Jekabs-Stikans/Servo_arm/Jēkaba Stikāna 2. kursa darba prezentācija.pptx

## Kursa darbs mehāniskas rokas vadības sistēma

Ventspils Augstskolas
Informācijas tehnoloģiju fakultātes
Profesionālā bakalaura studiju programmas „Elektronikas inženierija”
2. Kursa
Jēkaba Stikāna

## Saturs

- Darba mērķis un darba uzdevums
- Darba izstrādes process
1. Elektriskās principiālās shēmas izstrāde
2. Iespiedplates izstrāde
3. Shēmas lodēšana un montāža
- Secinājumi
- Izmantotie literatūras avoti

## Darba mērķis

- Izstrādāt mehāniskas rokas vadības sistēmu, kura spēj vadīt soļu motorus un satur attāluma sensoru apakšsistēmu.
- Izstrādāt projektu, kurš apvieno vairākus kursa darbus vienā.

## Darba uzdevums

- Izstrādāt mehāniskas rokas vadības sistēmu, kura var vadīt trīs soļu motorus un vienu servo motoru un satur sadursmes sensoru apakšsistēmu

## Elektroniski principiālā shēma

## Iespiedplates izstrāde

## Montāžas process

## Secinājumi

- Darba izstrādē tika sasniegti uzstādītie mērķi un nostiprinātas slektronisko shēmu projektēšanas prasmes
- Izstrādāto shēmu var turpmāk izmantot kā indikācijas sistēmu dažādās elektroniskās shēmās
- Darbu var optimizēt, izmantojot reģistru iebūvēto ieejas un izejas vadību
- Shēmu ir relatīvi viegli paplašināt uz vairāk nekā 4 ciparu izmantošanu

## Literatūras avoti

- MM74C912 mikroshēmas datu lapa
https:// (https://media.digikey.com/pdf/Data%20Sheets/Fairchild%20PDFs/MM74C912.pdf)media.digikey.com/pdf/Data%20Sheets/Fairchild%20PDFs/MM74C912.pdf
- [2] NE555 integrālās shēmas datu lapa
www.ti.com/product/NE555

## Paldies par uzmanību!
