Jekabs-Stikans/Servo_arm/Roboarm-5.png

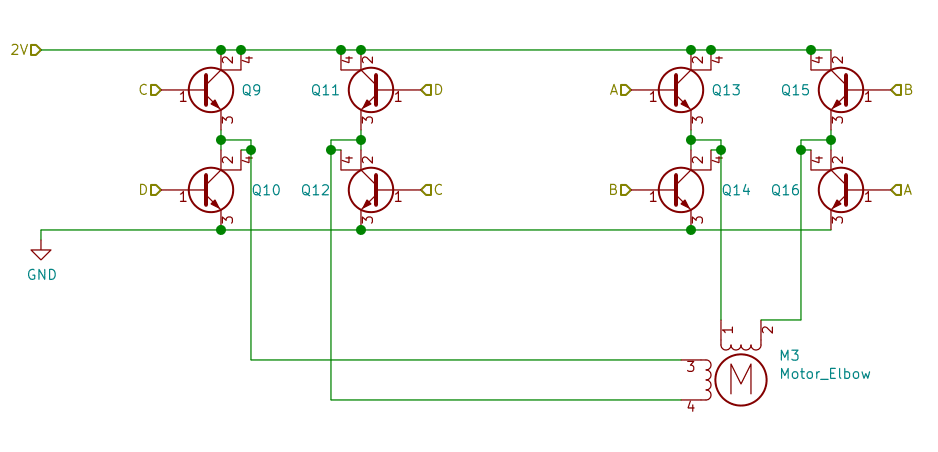
Roboarm-5.png
