Jekabs-Stikans/Servo_arm/Roboarm-6.png

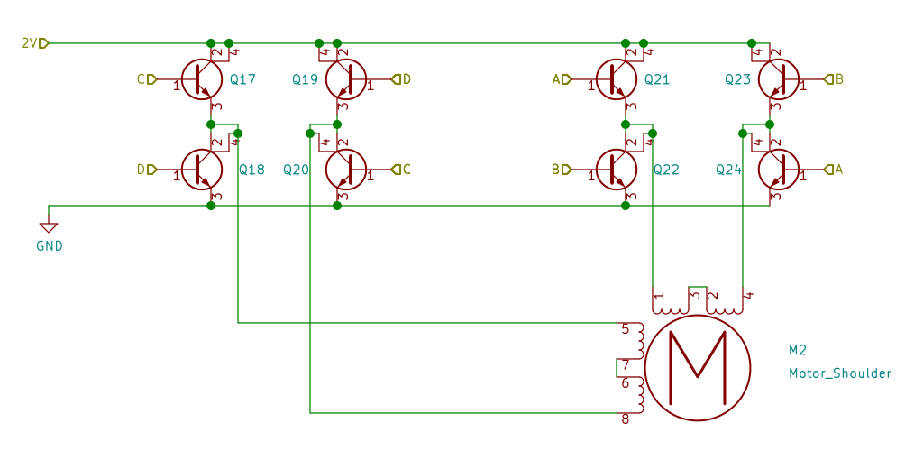
Roboarm-6.png
