Jekabs-Stikans/Servo_arm/Part list.ods

 | Jēkabs Stikāns
Nr | Nosaukums | Tiešsaiste
1 | FZT651 - Bipolar Transistor, NPN, 60 V, 2 W, 3 A, 200 hFE | https://lv.farnell.com/diodes-inc/fzt651/transistor-npn-60v-3a-sot-223/dp/9525009
2 | ST4118M1804-A - Stepper Motor, DC, 0.28 N-m, 1.8 A, Two Phase | https://lv.farnell.com/nanotec/st4118m1804-a/stepper-motor-2vdc-1-8a/dp/2507563
3 | ST5918M3008-A - Stepper Motor, DC, 0.88 N-m, 3 A, Two Phase | https://lv.farnell.com/nanotec/st5918m3008-a/stepper-motor-2-1vdc-3a/dp/2507567
4 | CRCW0805510RFKEA - SMD Chip Resistor, 0805 [2012 Metric], 510 ohm | https://lv.farnell.com/vishay/crcw0805510rfkea/res-510r-1-0-125w-0805-thick-film/dp/1653016
5 | PR02000201000JA100 - Through Hole Resistor, 100 ohm, 2 W, ± 5% | https://lv.farnell.com/vishay/pr02000201000ja100/res-100r-5-2w-axial-metal-film/dp/2614520
6 | LM358ADGKR - Operational Amplifier, 2 amplifiers 3V to 32V,MSOP, 8 Pins | https://lv.farnell.com/texas-instruments/lm358adgkr/op-amp-high-gain-700khz-msop-8/dp/3117063
7 | BC817 - Bipolar Single Transistor, NPN, 45 V, 250 mW, 500 mA, 250 hFE | https://lv.farnell.com/nexperia/bc817-40-215/transistor-npn-45v-0-5a-sot23/dp/1081225RL
8 | C0805X104K5RAC3316 - SMD Ceramic Capacitor, FT-CAP, 0.1 µF, 50 V, 0805 [2012 Metric], ± 10% | https://lv.farnell.com/kemet/c0805x104k5rac3316/cap-0-1-f-50v-10-x7r-0805/dp/2666896
9 | EEEFK1C220UR - SMD Electrolytic Capacitor, Radial Can, 22 µF, 16 V | https://lv.farnell.com/panasonic/eeefk1c220ur/cap-22-f-16v-radial-smd/dp/9695656
10 | EEEFC1H1R0R - SMD Electrolytic Capacitor, Radial Can, 1 µF, 50 V | https://lv.farnell.com/panasonic/eeefc1h1r0r/cap-1-f-50v-radial-smd/dp/9694528
11 | EEEFP1E100AR - SMD Electrolytic Capacitor, Radial Can, 10 µF, 25 V | https://lv.farnell.com/panasonic/eeefp1e100ar/cap-10-f-25v-radial-smd/dp/1539481
12 | SRN1060-331M - Power Inductor (SMD), 330 µH, 900 mA, Semishielded, 10mm x 9.8mm x 6mm | https://lv.farnell.com/bourns/srn1060-331m/inductor-330uh-20-0-9a-smd/dp/2329195
13 | TS53YJ104MR10 - Trimmer Potentiometer, 100 kohm, SMD, 250 mW, ± 20% | https://lv.farnell.com/vishay/ts53yj104mr10/trimmer-pot-100k-1turn-smd/dp/1141488
14 | TS53YL103MR10 - Trimmer Potentiometer, 10 kohm, 1 Turns, SMD, 250 mW, ± 20% | https://lv.farnell.com/vishay/ts53yl103mr10/trimmer-pot-10k-1turn-smd/dp/1141474
15 | S1ML R3 - Standard Recovery Diode, 1 kV, 1 A, Single, 1.1 V, 1.8 µs, 30 A | https://lv.farnell.com/taiwan-semiconductor/s1ml-r3/diode-sgp-1a-1000v/dp/1559155
