Jekabs-Stikans/Servo_arm/Roboarm.pdf

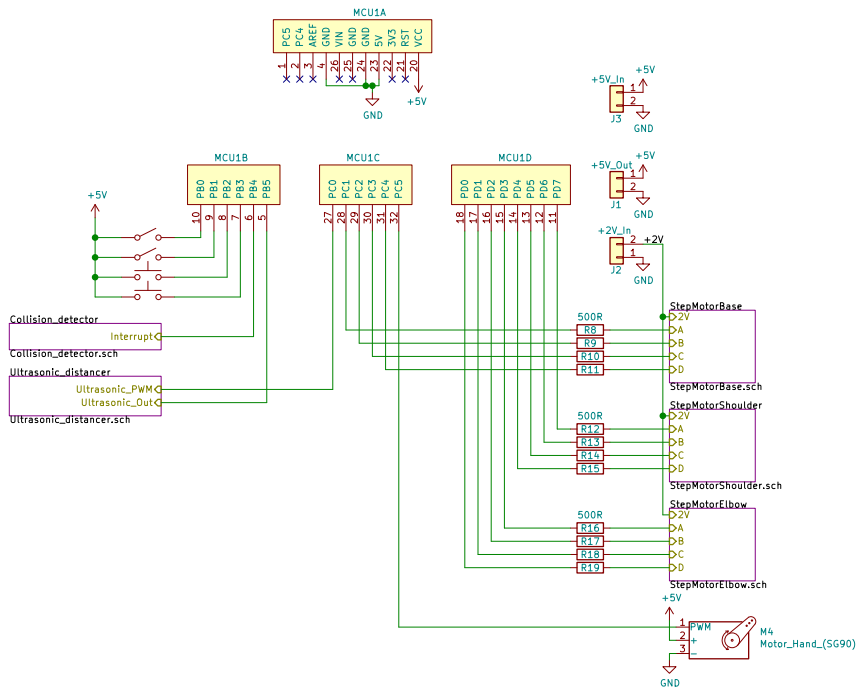
[picture p29: page 1]

2 VCC 20 RST 21 3V3 22 5V 23 GND 24 GND 25 VIN 26 AREF

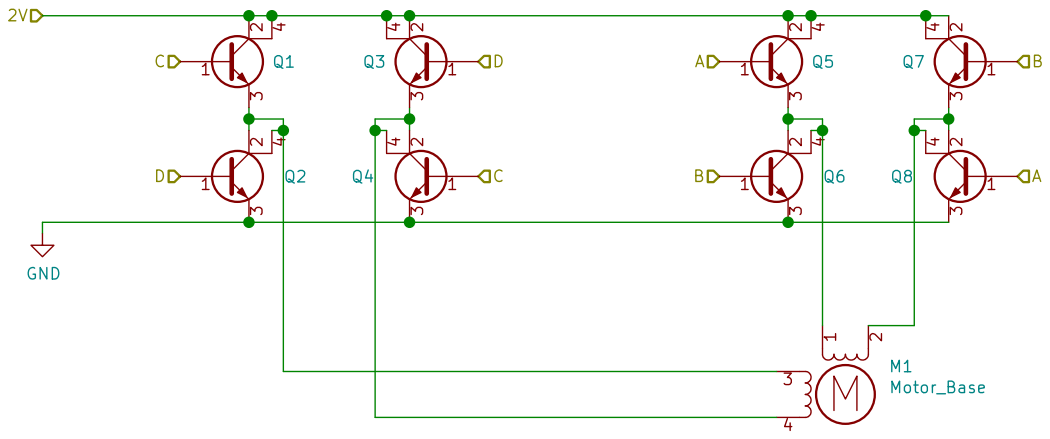
[picture p30: page 2]

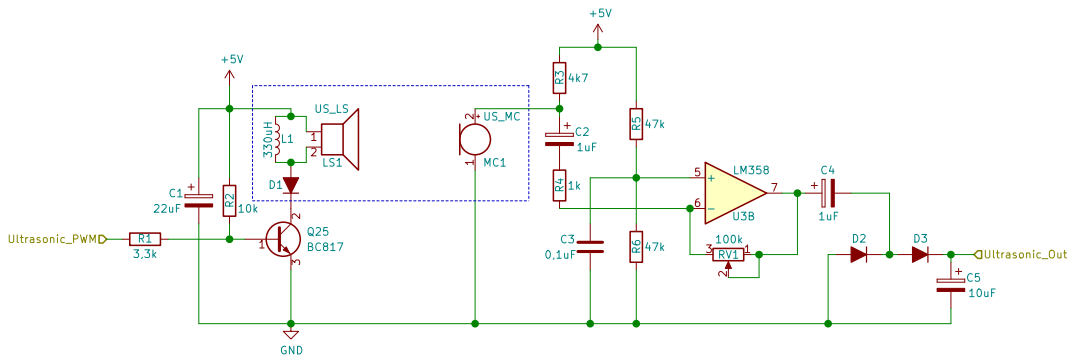
[picture p31: page 3]

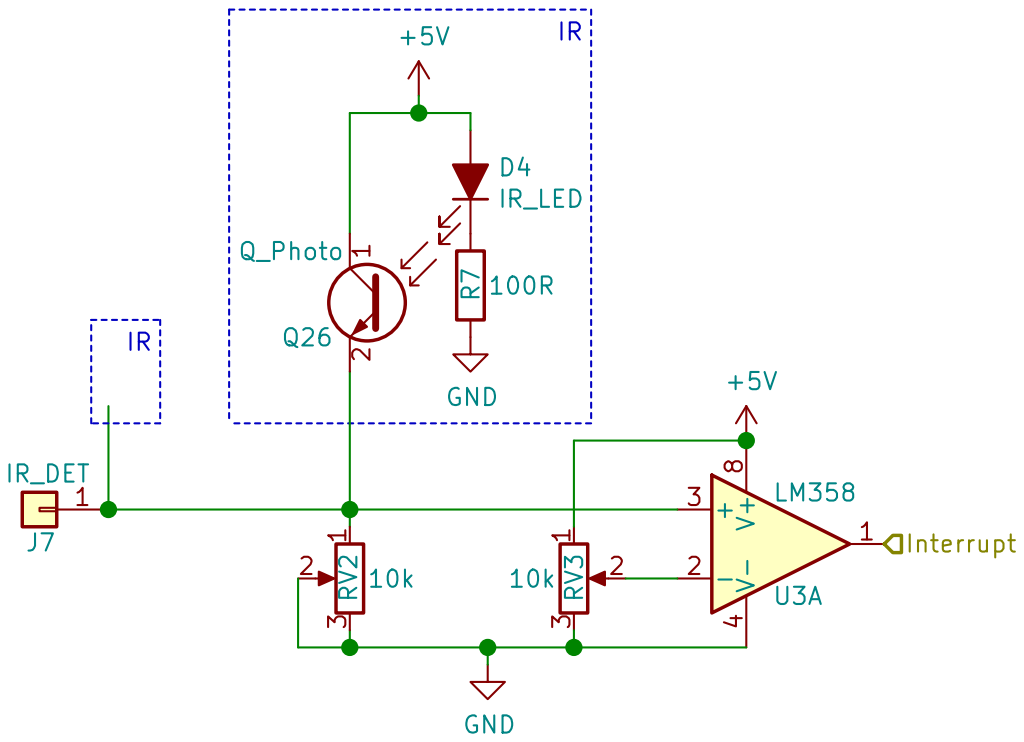
[picture p32: page 4]

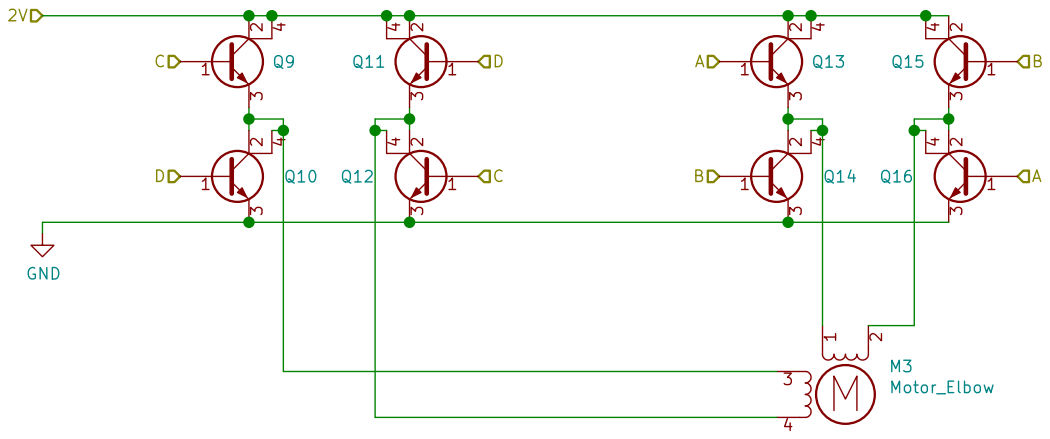
[picture p33: page 5]

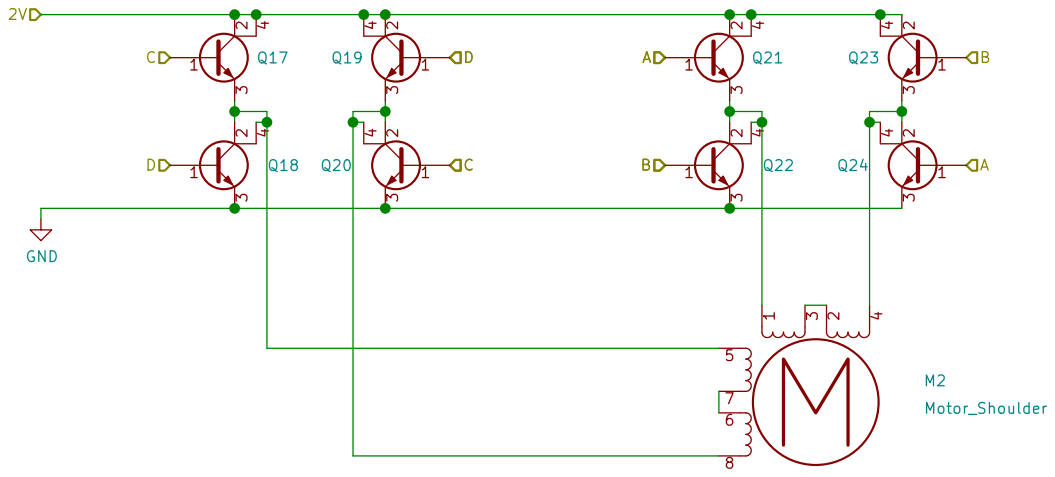
[picture p34: page 6]
