Jekabs-Stikans/Servo_arm/Roboarm PCB.pdf

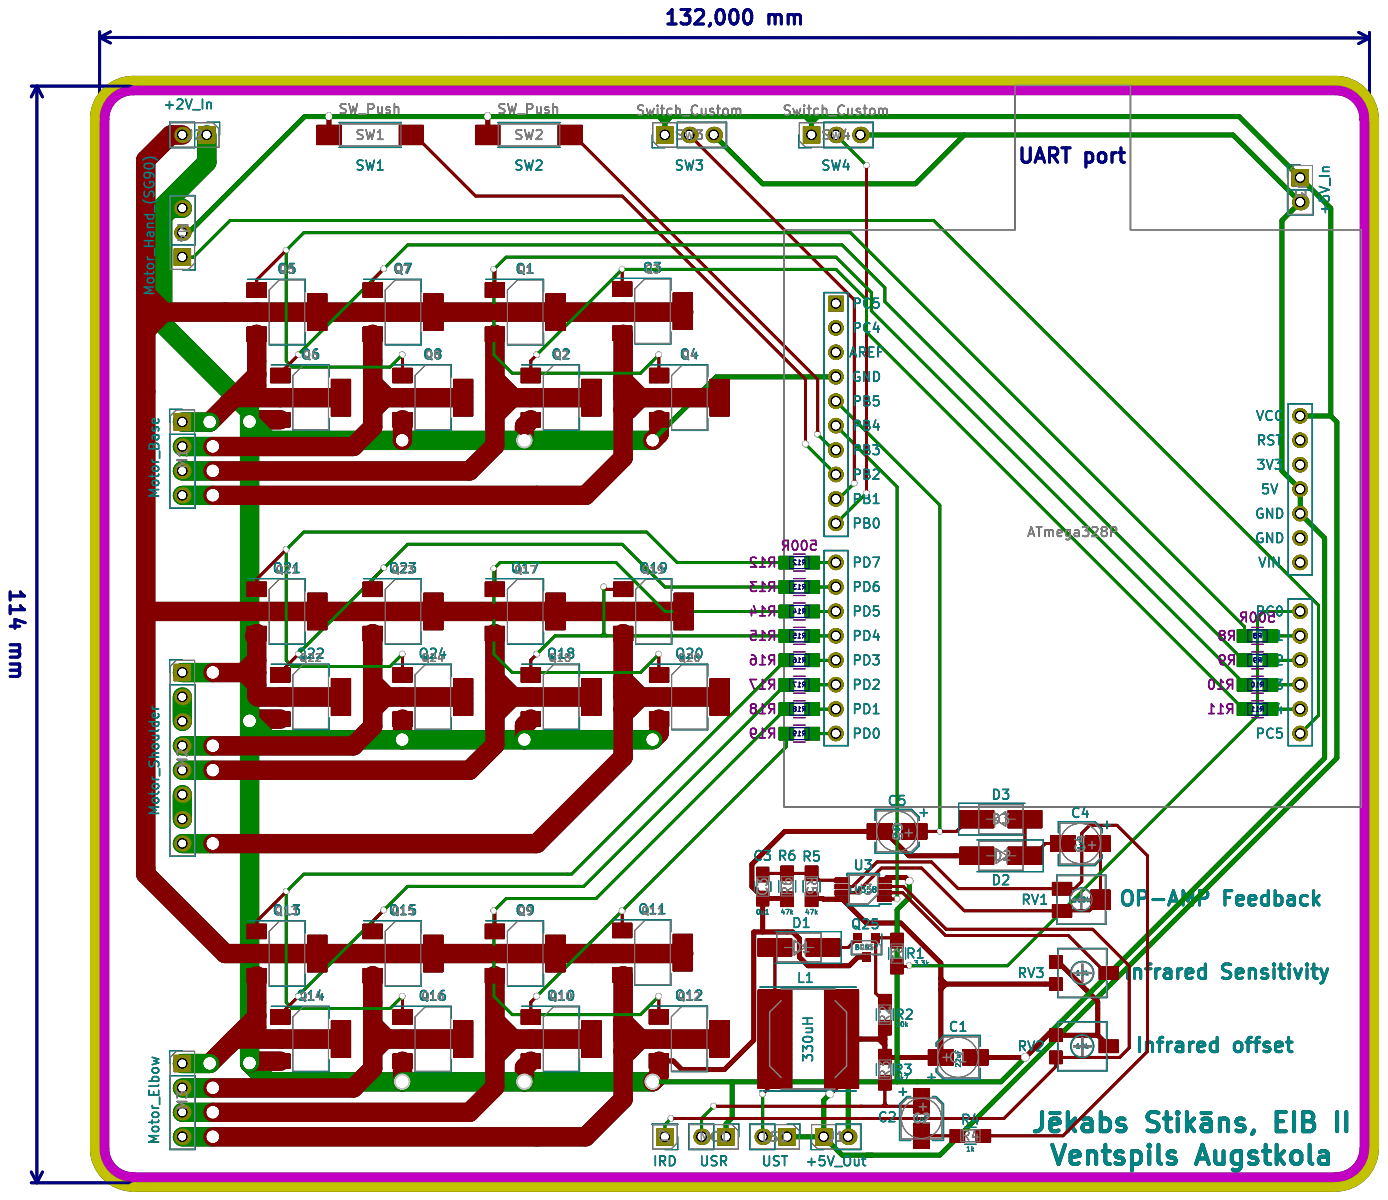
[picture p35: page 1]
