Jekabs-Stikans/Servo_arm/Roboarm/Roboarm-F_SilkS.pdf

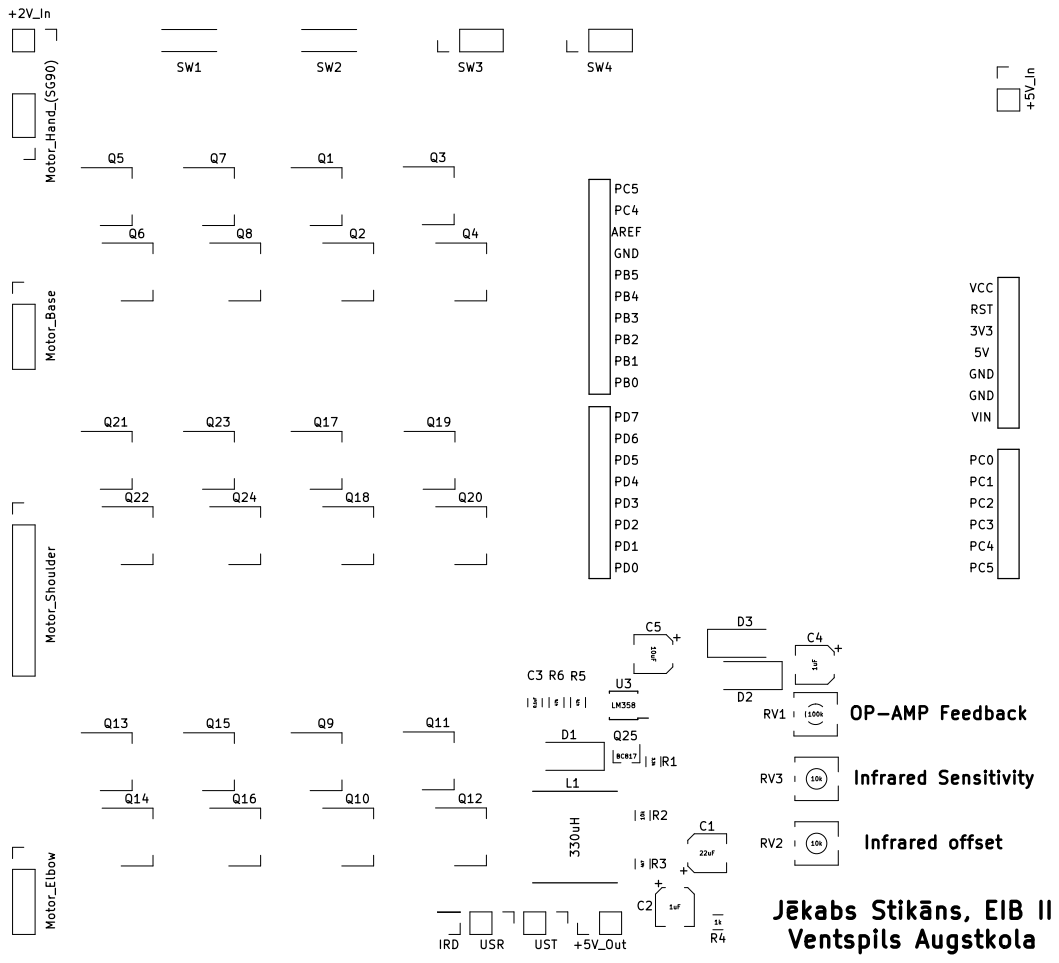
[picture p36: page 1]

Infrared offset OP-AMP Feedback Jkabs Stikns, EIB II
