Jekabs-Stikans/Servo_arm/Roboarm/Roboarm.kicad_pcb

## KiCad design Roboarm/Roboarm.kicad_pcb (2021-03-26)

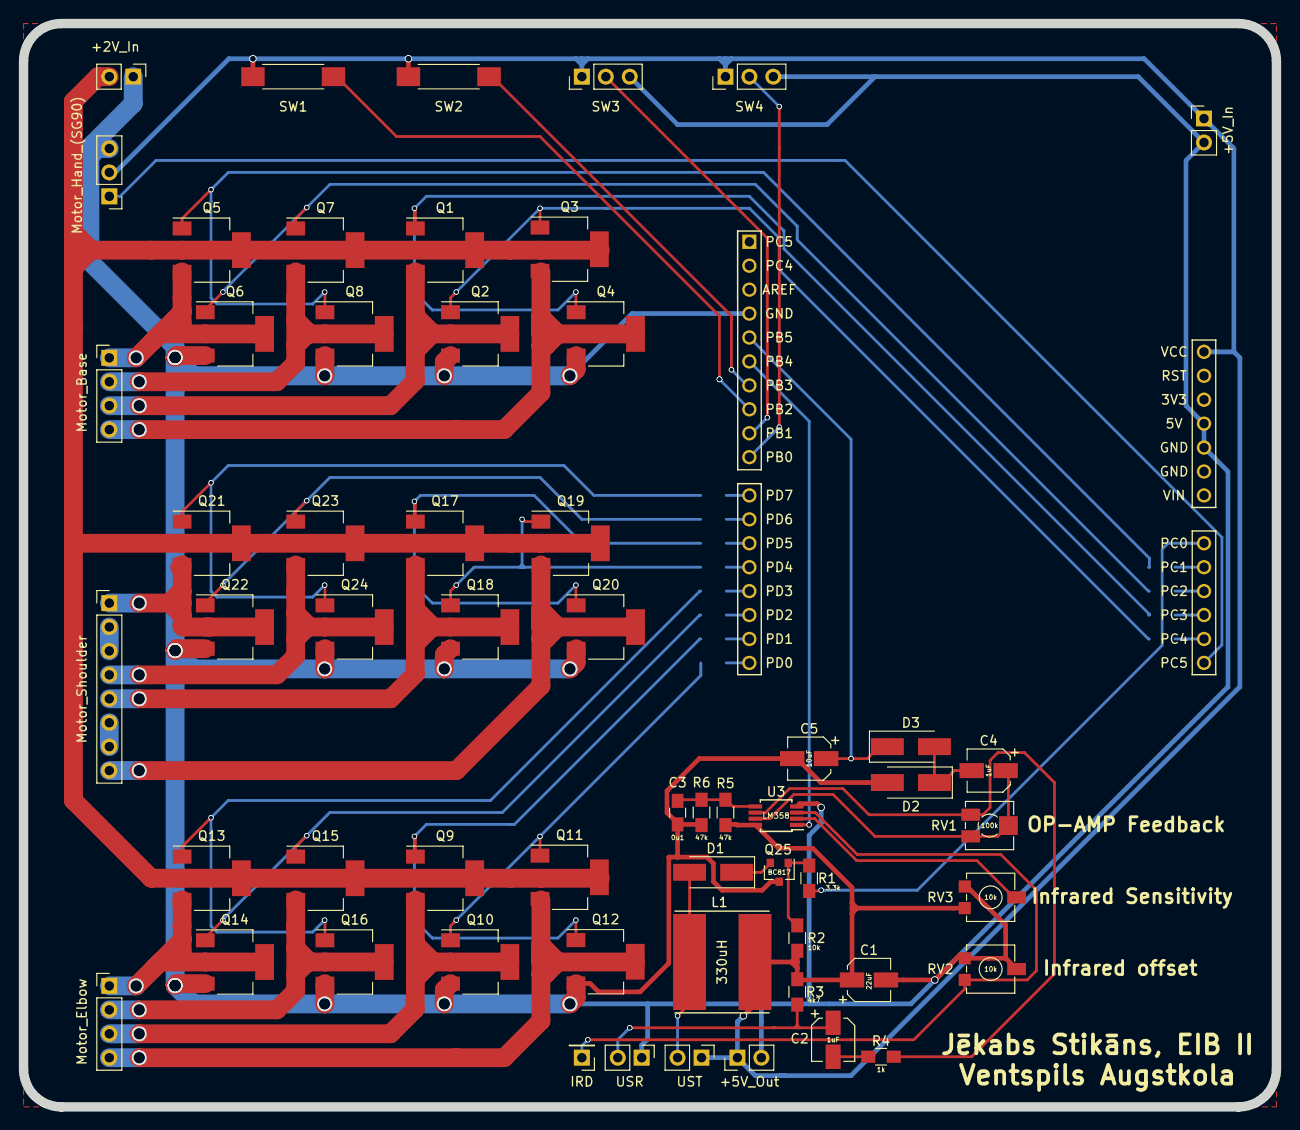
[picture p37: board Roboarm.kicad_pcb from above]

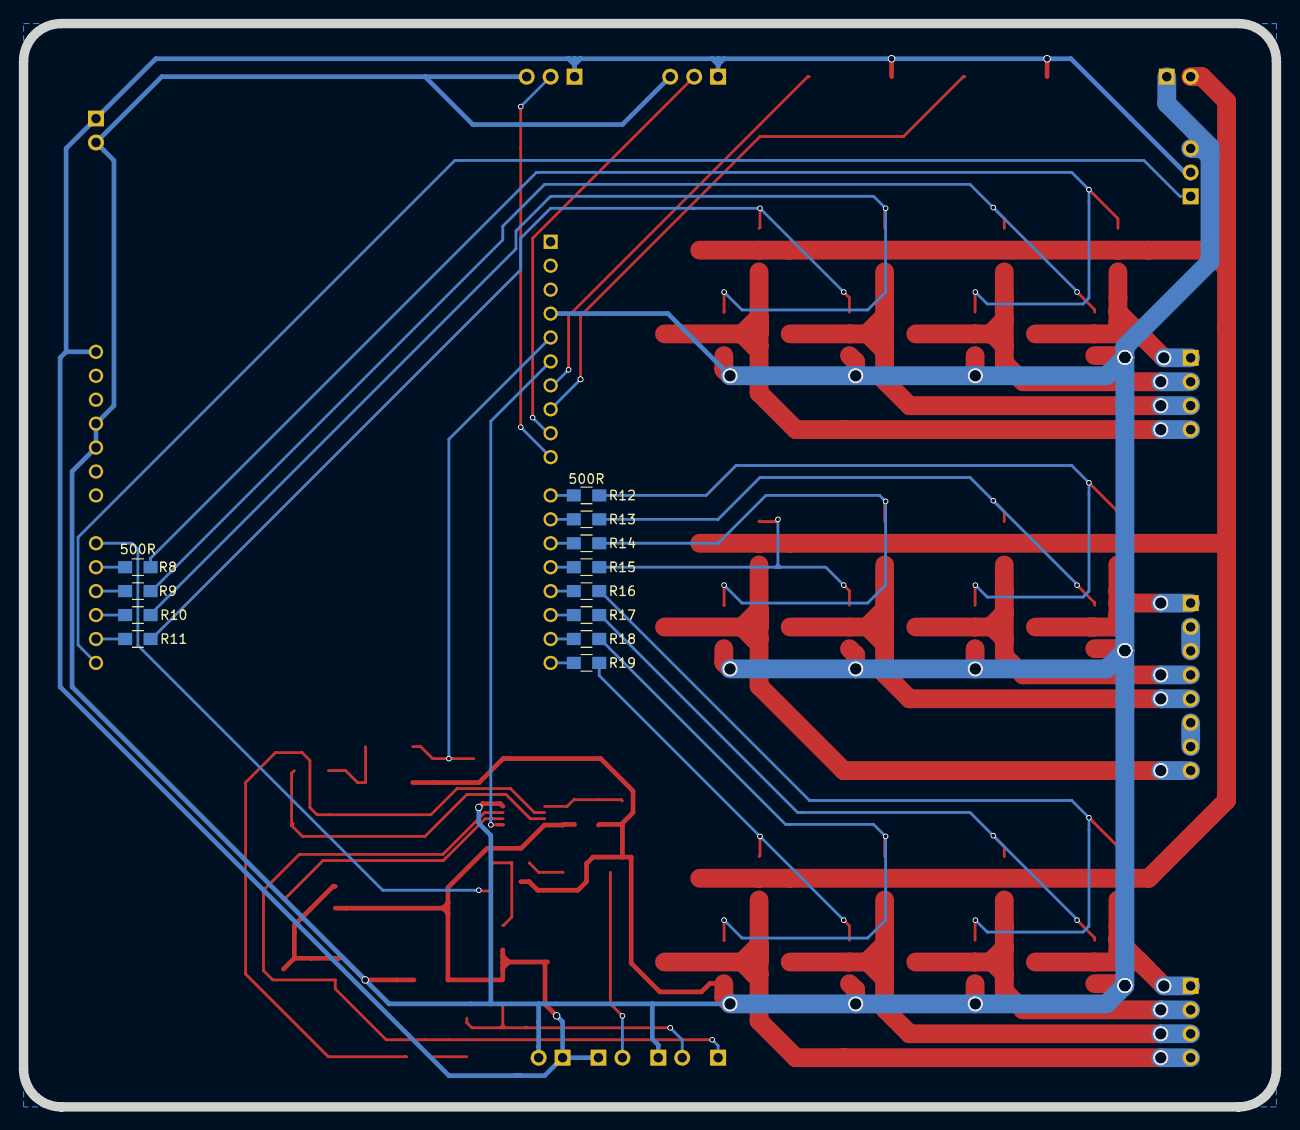
[picture p38: board Roboarm.kicad_pcb from below]

Board: 2 copper layers, 133.0 x 115.0 mm, 71 parts (12 on the bottom side), 60 nets.

Parts:
C1: 22uF; CP_Elec_4x5.3
C2, C4: 1uF; CP_Elec_4x5.3
C3: 0u1; C_0805_HandSoldering
C5: 10uF; CP_Elec_4x5.3
D1, D2, D3: D_ALT; D_SMA_Handsoldering
J1: +5V_Out; Pin_Header_Straight_1x02_Pitch2.54mm
J2: +2V_In; Pin_Header_Straight_1x02_Pitch2.54mm
J3: +5V_In; Pin_Header_Straight_1x02_Pitch2.54mm
J7: IRD; Pin_Header_Straight_1x01_Pitch2.54mm
L1: 330uH; Inductor_Taiyo-Yuden_NR-80xx_HandSoldering
LS1: UST; Pin_Header_Straight_1x02_Pitch2.54mm
M1: Motor_Base; Pin_Header_Straight_1x04_Pitch2.54mm
M2: Motor_Shoulder; Pin_Header_Straight_1x08_Pitch2.54mm
M3: Motor_Elbow; Pin_Header_Straight_1x04_Pitch2.54mm
M4: Motor_Hand_(SG90); Pin_Header_Straight_1x03_Pitch2.54mm
MC1: USR; Pin_Header_Straight_1x02_Pitch2.54mm
MCU1: ATmega328P; ATmega328P_Xplained_mini
Q1, Q2, Q3, Q4, Q5, Q6, Q7, Q8, Q9, Q10, Q11, Q12, Q13, Q14, Q15, Q16, Q17, Q18, Q19, Q20, Q21, Q22, Q23, Q24: FZT651; SOT-223
Q25: BC817; SOT-23
R1: 3,3k; R_0805_HandSoldering
R2: 10k; R_0805_HandSoldering
R3: 4k7; R_0805_HandSoldering
R4: 1k; R_0805_HandSoldering
R5, R6: 47k; R_0805_HandSoldering
R8, R9, R10, R11, R12, R13, R14, R15, R16, R17, R18, R19: 500R; R_0805_HandSoldering
RV1: 100k; Potentiometer_Trimmer_Vishay_TS53YJ
RV2, RV3: 10k; Potentiometer_Trimmer_Vishay_TS53YL
SW1, SW2: SW_Push; SW_SPST_REED_CT05-XXXX-G1
SW3, SW4: Switch_Custom; PinHeader_1x03_P2.54mm_Vertical
U3: LM358; MSOP-8_3x3mm_Pitch0.65mm

Connections:
+5V: C1.1, J1.1, J3.1, L1.2, LS1.1, M4.2, MCU1.20, R2.1, R3.1, R5.1, RV3.1, SW1.1, SW2.1, SW3.1, SW4.1, U3.8
/+2V: J2.2, Q1.2, Q1.4, Q3.2, Q3.4, Q5.2, Q5.4, Q7.2, Q7.4, Q9.2, Q9.4, Q11.2, Q11.4, Q13.2, Q13.4, Q15.2, Q15.4, Q17.2, Q17.4, Q19.2, Q19.4, Q21.2, Q21.4, Q23.2, Q23.4
/Collision_detector/Interrupt: MCU1.6, U3.1
/StepMotorBase/A: Q5.1, Q8.1, R8.1
/StepMotorBase/B: Q6.1, Q7.1, R9.1
/StepMotorBase/C: Q1.1, Q4.1, R10.1
/StepMotorBase/D: Q2.1, Q3.1, R11.1
/StepMotorElbow/A: Q13.1, Q16.1, R16.1
/StepMotorElbow/B: Q14.1, Q15.1, R17.1
/StepMotorElbow/C: Q9.1, Q12.1, R18.1
/StepMotorElbow/D: Q10.1, Q11.1, R19.1
/StepMotorShoulder/A: Q21.1, Q24.1, R12.1
/StepMotorShoulder/B: Q22.1, Q23.1, R13.1
/StepMotorShoulder/C: Q17.1, Q20.1, R14.1
/StepMotorShoulder/D: Q18.1, Q19.1, R15.1
/Ultrasonic_distancer/Ultrasonic_Out: C5.1, D3.1, MCU1.5
/Ultrasonic_distancer/Ultrasonic_PWM: MCU1.27, R1.1
GND: C1.2, C3.2, C5.2, D2.2, J1.2, J2.1, J3.2, M4.3, MC1.1, MCU1.4, MCU1.23, MCU1.24, Q2.3, Q4.3, Q6.3, Q8.3, Q10.3, Q12.3, Q14.3, Q16.3, Q18.3, Q20.3, Q22.3, Q24.3, Q25.3, R6.2, RV2.2, RV2.3, RV3.3, SW3.3, SW4.3, U3.4
unnamed: C2.1, MC1.2, R3.2
unnamed: C2.2, R4.1
unnamed: C3.1, R5.2, R6.1, U3.5
unnamed: C4.1, RV1.1, RV1.2, U3.7
unnamed: C4.2, D2.1, D3.2
unnamed: D1.1, Q25.2
unnamed: D1.2, L1.1, LS1.2
unnamed: J7.1, RV2.1, U3.3
unnamed: M1.1, Q5.3, Q6.2, Q6.4
unnamed: M1.2, Q7.3, Q8.2, Q8.4
unnamed: M1.3, Q1.3, Q2.2, Q2.4
unnamed: M1.4, Q3.3, Q4.2, Q4.4
unnamed: M2.1, Q21.3, Q22.2, Q22.4
unnamed: M2.2, M2.3
unnamed: M2.4, Q23.3, Q24.2, Q24.4
unnamed: M2.5, Q17.3, Q18.2, Q18.4
unnamed: M2.6, M2.7
unnamed: M2.8, Q19.3, Q20.2, Q20.4
unnamed: M3.1, Q13.3, Q14.2, Q14.4
unnamed: M3.2, Q15.3, Q16.2, Q16.4
unnamed: M3.3, Q9.3, Q10.2, Q10.4
unnamed: M3.4, Q11.3, Q12.2, Q12.4
unnamed: M4.1, MCU1.32
unnamed: MCU1.7, SW2.2
unnamed: MCU1.8, SW1.2
unnamed: MCU1.9, SW3.2
unnamed: MCU1.10, SW4.2
unnamed: MCU1.11, R12.2
unnamed: MCU1.12, R13.2
unnamed: MCU1.13, R14.2
unnamed: MCU1.14, R15.2
unnamed: MCU1.15, R16.2
unnamed: MCU1.16, R17.2
unnamed: MCU1.17, R18.2
unnamed: MCU1.18, R19.2
unnamed: MCU1.28, R8.2
unnamed: MCU1.29, R9.2
unnamed: MCU1.30, R10.2
unnamed: MCU1.31, R11.2
unnamed: Q25.1, R1.2, R2.2
unnamed: R4.2, RV1.3, U3.6
unnamed: RV3.2, U3.2
